CallidusRobot/Documentation/CAD.md

# CAD
## TODO: Design
- Battery holder

## Remarks
- Magnetometer and accelerometer should be on-axis and away from electric/magnetic fields
- Battery should be easy and tool-less to remove
- PCB should be upside-down and have USB-connector on the right side
- ToF view should be un-obstructed
- RFID should be mounted as far away from ground as possible
- Speaker could be part of inner frame assembly (pointing itself down) towards the edge and be slotted in rails, before the frame is installed
- Battery could also be part of the inner frame assembly by being put in a well, where it just rests (perhaps with top cover)

## TODO: Print
- Battery holder (3x after design)

## Done
- Outer frame
- Diffusor
- Triggers (Home and Power-ups)
- Inner frame with PCB
- Cannon diffusor
- Camera/ToF assembly
- Cannon base
- Motor/RFID/Line sensor assembly
- Top cover with DMD, accelerometer and magnetometer mounts
- WS2812 Cannon
- Speaker holder
