CallidusRobot/Documentation/Roadblocks.md

# Roadblocks

- Raspberry Pi Pico statt Teensy LC
- LEDs brauchen deutlich mehr Strom als erwartet
- Zeitmangel
- Original-Stecker sind schwer zu finden
- Kein Zugang zu Papier-Drucker oder 3D-CAD-Software in Wohnung
- Regulator sollte 500mA schaffen, aber auf Seite 8 schon im Beispiel wiederlegt
- Kamera läuft teilweise mit 5V und teilweise mit 3.3V
- Konnektoren auf der falschen Seite der Platine -> Re-engineering
- RFID-Reader wirklich kompatibel zu den NFC-Tags?
- Raspberry Pi Pico erfordert Low-Drop-Diode auf VSYS
- Regulatoren plötzlich ausverkauft -> Power Path Management muss mehrfach umgebaut werden
- Zeitmangel
- Platzmangel in allen Richtungen
- Unbekannt, ob original Lipo von den Abmessungen und vom Strom her ausreicht
- Windows Update.
- Vertauschte Symbole auf der PCB
- Originale Akkus liefern nur 400mA (2A peak), 2.5A continuous und 5A peak sind aber mindestens erforderlich
- Der RFID-Reader ist mit den gekauften Tags nicht kompatibel und ist auch abgesehen davon absoluter Schrott
- Noch mehr vertauschte Symbole auf der PCB
- RFID-Leser braucht <2cm Leseabstand
- AZ-Delivery weigert sich eine korrekte Rechnung auszustellen
- Deutsche Post
- Zeitmangel
- Erster Routingfehler in der PCB (VBAT divider)
- Zweiter Routingfehler in der PCB (U2 VCC)
- 3V3 auch ohne Regulator auf 3.7V?!
