CallidusRobot/Documentation/RFID.md

# RFID

## Known cards
- 13 2C 86 16 (Red 0)
- 13 64 9E 16 (Green 0)
- F3 2B 8D 16 (Blue 0)
- A3 77 93 16 (Red 1)
- 03 95 88 16 (Green 1)
- 13 53 87 16 (Blue 1)
- 63 10 90 16 (Powerup 0)
- 83 ED 8C 16 (Powerup 1)
- 53 50 95 16 (Powerup 2)
- A3 EB 84 16 (Powerup 3)
- 13 45 96 16 (Powerup 4)
- 33 9E 97 16 (Powerup 5)
