CallidusRobot/Documentation/WiFi-Camera.md

# WiFi-Camera
The required WiFi camera module passes messages between the controller and the commander.
It also provides a live video stream for a PoV display or object recognition.
