CallidusRobot/Documentation/Controller.md

# Controller
The Raspberry Pi Pico on the robot's circuit board is also known as the (real-time) controller.

## TODO
### High priority
- Implement messages via WiFi
- Movement with direction and distance
- RFID contents sent as message
- Power management and logging via messages
- Initial calibration
- Line boundary tracking
- Basic WS2812

## Medium priority
- Get sound working
- Improve accuracy with magnetometer and accelerometer
- Graphics support
- Personality EEPROM
- Basic PC game

## Low priority
- Animations
- Effects on WS2812
- Advances PC game
