CallidusRobot/Documentation/UART.md

# UART
## WiFi-MCU
115200 8N1

## Sound-Player
9600 8N1
