CallidusRobot/Documentation/IIC.md

# IIC devices
## Digital compass: LIS3MDL
Address: 0x1C

## RGB DMD: IS31FL3741
Address: 0x30

## Multi target: VL53L1X
Address: 0x29
