CallidusRobot/Documentation/Display.png

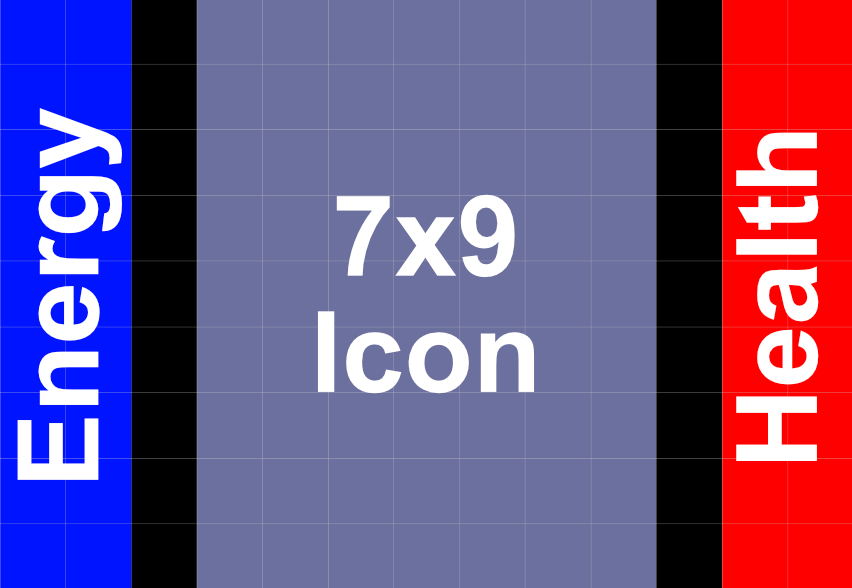
Display.png
