CallidusRobot/Documentation/Purchases.md

# Purchases
All done!

## Done
- AZ-Delivery: 7.49€ (refuses to issue a correct invoice!)

## Done with invoice
- EXP-Tech: 64.29€
- eBay: 12.82€ (Abstandshalter), 14.50€ (High-side switches)
- TME: 73.97€
- Modellbaucenter Bochum: 35.26€ (Akkus)
- Conrad: 36.94€ (Billiges 2S Netzladeteil)
- BerryBase: 48.30€ (Accelerometer)
- AISLER: 38.27€

## Sum
331.84€
