CallidusRobot/Documentation/Components original.pdf

Bauteil | Anzah l | Link
RFID-Tag (3x10) | 3 | https://www.berrybase.de/rfid/nfc-tags-ntag215-25mm-selbstkleb end-weiss-10-stueck (https://www.berrybase.de/rfid/nfc-tags-ntag215-25mm-selbstklebend-weiss-10-stueck)
RFID-Reader | 3 | https://www.berrybase.de/rfid-lesegeraet-mit-spi-schnittstelle-inkl .-karte-dongle (https://www.berrybase.de/rfid-lesegeraet-mit-spi-schnittstelle-inkl.-karte-dongle)
WS2812 60LED/m | 5m | https://www.ebay.de/itm/373668582675
Laserpointer (3x) | 3 | TBD
Fotosensor | 6 | TBD
Adafruit IS31FL3741 | 3 | https://www.berrybase.de/adafruit-is31fl3741-13x9-pwm-rgb-led-matrix-treiber (https://www.berrybase.de/adafruit-is31fl3741-13x9-pwm-rgb-led-matrix-treiber)
3W Lautsprecher (x4) | 1 | https://www.ebay.de/itm/373285241139
Magnetsensor | 3 | https://www.berrybase.de/adafruit-drei-achsen-magnetometer-lis 3mdl (https://www.berrybase.de/adafruit-drei-achsen-magnetometer-lis3mdl)
MicroSD 4GB | 3 | https://www.berrybase.de/intenso-microsdhc-class-10-speicherk arte-4gb (https://www.berrybase.de/intenso-microsdhc-class-10-speicherkarte-4gb)
DFPlayer | 3 | https://www.berrybase.de/mp3-player-modul-mit-eingebautem-ve rstaerker (https://www.berrybase.de/mp3-player-modul-mit-eingebautem-verstaerker)
Eigene PCB (TODO) | 3 | https://aisler.net/
Teensy LC | 3 | https://www.berrybase.de/teensy-lc-ohne-header
VL53L3X | 3 | https://www.berrybase.de/pololu-vl53l3cx-time-of-flight-multi-targ et-distanzsensor-mit-spannungsregler-bis-500cm (https://www.berrybase.de/pololu-vl53l3cx-time-of-flight-multi-target-distanzsensor-mit-spannungsregler-bis-500cm)
JST PH2 Buchse | 20 | https://www.berrybase.de/ph2.0-buchse-printmontage-gerade-2-pin?c=112 (https://www.berrybase.de/ph2.0-buchse-printmontage-gerade-2-pin?c=112)
Motortreiber | 4 | https://www.berrybase.de/sparkfun-motor-treiber-dual-tb6612fng-mit-headern (https://www.berrybase.de/sparkfun-motor-treiber-dual-tb6612fng-mit-headern)
Qwiic Adapterkabel | 6 | https://www.berrybase.de/sparkfun-qwiic-flexibles-adapterkabel-4-pin-dupont-female-150mm (https://www.berrybase.de/sparkfun-qwiic-flexibles-adapterkabel-4-pin-dupont-female-150mm)
