CallidusRobot/Documentation/(list of files, drawings)

Other design files:
Block diagram.spl8
Venue.spl8
