CallidusRobot/Documentation/(commit log)

2022-10-05 Create Power budgeting.md
2022-10-05 Update Power budgeting.md
2022-10-11 Added more graphics to explain directions
    [Venue.spl8]
2022-10-25 Decided to drop the additional ADC
2022-10-25 Changed fuses
2022-10-26 High side switch purchase
2022-10-28 Updated the block diagram
    [Block diagram.spl8]
2022-10-28 Update Block diagram.spl8
    [Block diagram.spl8]
2022-11-06 Added the accelerometer to the block diagram
    [Block diagram.spl8]
